LeoLiu8023AmyLu/SmartNFBP/README.md

# SmartNFBP
智能盲杖 Android App 挑战杯 智慧城市 代码
