LeoLiu8023AmyLu/SmartNFBP/SmartNFBP_Arduino_2015.7.15/版本说明.txt

///////////////////////////////////////////////////////////////////////////////
/////                                                                   ///////
/////                            版本说明                               ///////
/////                                                                   ///////
///////////////////////////////////////////////////////////////////////////////

2015.7.14
改变了IC 读卡的输出
把16进制的数字输出 改编成了 ASIC 码
