LeoLiu8023AmyLu/SmartNFBP/ic_launcher-web.png

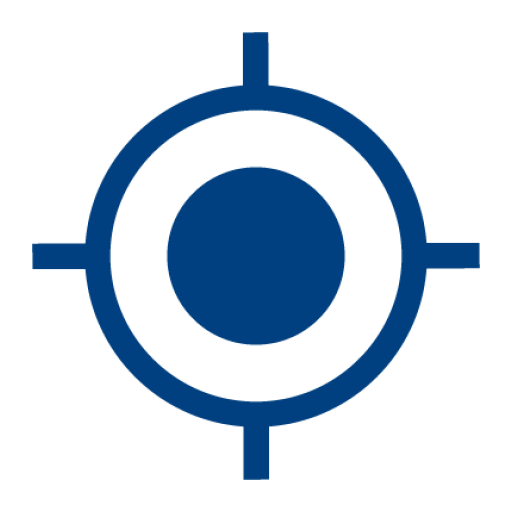
ic_launcher-web.png
