LeoLiu8023AmyLu/SmartNFBP/论文/挑战杯论文 201507/流程图 英文版 APP.png

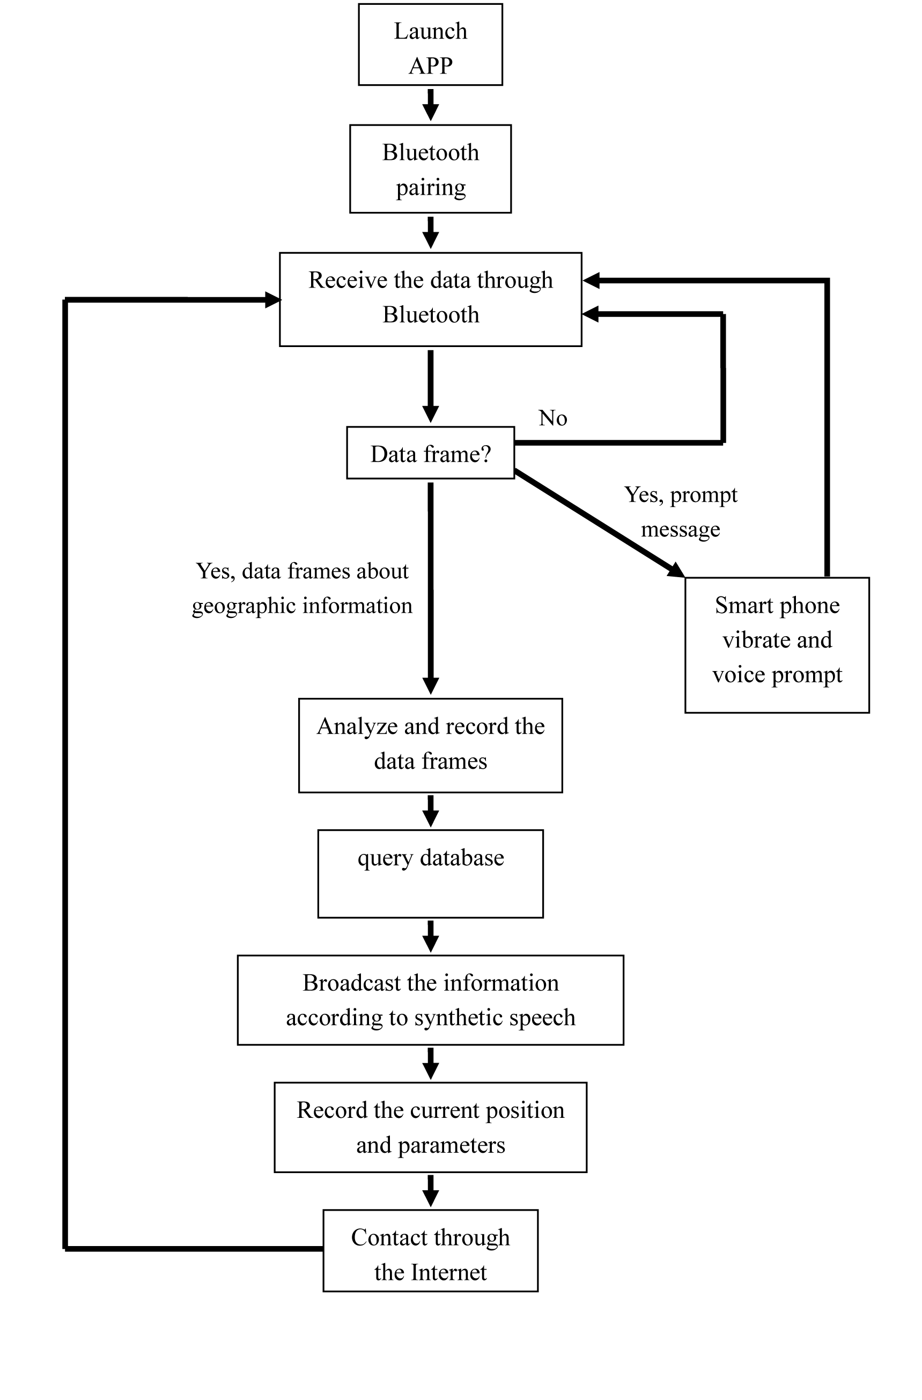
论文/挑战杯论文 201507/流程图 英文版 APP.png
