LeoLiu8023AmyLu/SmartNFBP/(list of files, drawings)

Other design files:
SmartNFBP_Arduino_2015.7.15/Arduino PCB/Arduino/啊度no.PcbDoc
SmartNFBP_Arduino_2015.7.15/Arduino PCB/Arduino/啊度no.PrjPcb
SmartNFBP_Arduino_2015.7.15/Arduino PCB/Arduino/啊度no.SchDoc
