LeoLiu8023AmyLu/SmartNFBP/(commit log)

2017-03-10 智能盲杖 Andorid App
2017-05-10 更新项目相关资料及程序
2017-05-17 更新存档程序文件，更新项目计划书
2017-05-27 更新 蒋晓东 PCB 文件
    [啊度no.PcbDoc, 啊度no.PrjPcb, 啊度no.SchDoc]
